bartoszp1992/boardConsole2/doc/datasheets/555 ignition circuit.png

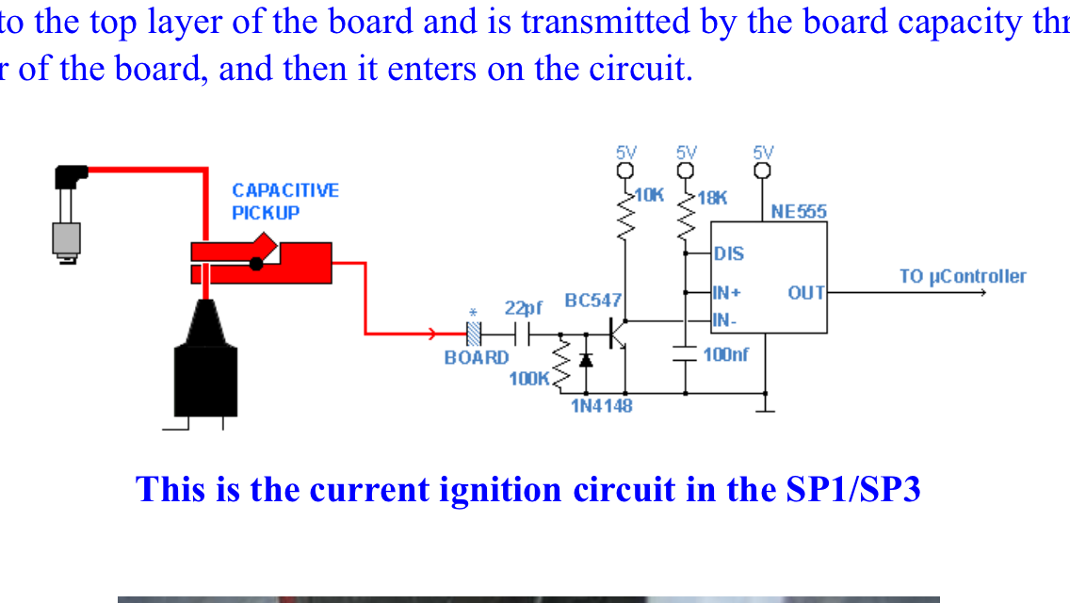
doc/datasheets/555 ignition circuit.png
