bartoszp1992/boardConsole2/boardConsolePCB/output/V2/boardConsolePCB_BOM.ods

Id | Designator | Footprint | Quantity | Designation | Supplier and ref
1 | C18,C24 | CP_D8mm_H13mm_P3.5mm_horizontal | 2 | 100u
2 | D1,D4,D3 | LED_0603_1608Metric | 3 | LED
3 | R27,R13,R12,R28,R26 | R_0603_1608Metric | 5 | 4k7
4 | L1 | C_0603_1608Metric | 1 | 47n
5 | R33,R39,R37,R14,R32,R23,R25,R20,R4,R6 | R_0603_1608Metric | 10 | 1k
6 | C9,C40,C32,C11,C5,C16,C39,C4,C29,C14,C17,C22,C37,C1,C6,C38,C23 | C_0603_1608Metric | 17 | 100n
7 | R40,R24,R2,R36,R41,R5,R38,R19 | R_0603_1608Metric | 8 | 10k
8 | D6 | LED_0603_1608Metric | 1 | STAT2
9 | R15,R7,R18 | R_1206_3216Metric | 3 | 220R
10 | BT1 | BatteryHolder_Keystone_1060_1x2032 | 1 | CH004-2032
11 | C10,C28 | CP_D8mm_H13mm_P3.5mm_horizontal | 2 | 0m1
12 | U6 | TO-252-2 | 1 | AZ1117-5.0
13 | F3,F2 | Fuse_0603_1608Metric | 2 | 100mA
14 | R16,R17 | R_2512_6332Metric | 2 | 0R
15 | C25 | C_0603_1608Metric | 1 | 100p/0R
16 | U9 | DIP-8_W7.62mm | 1 | AT24C04C
17 | F1 | Fuse_1206_3216Metric | 1 | 1A
18 | C36,C21,C34,C20,C35,C19,C33,C15 | C_0603_1608Metric | 8 | 1u
19 | U8 | TSSOP-20_4.4x6.5mm_P0.65mm | 1 | TXS0108EPW
20 | R29,R30,R31 | R_0805_2012Metric | 3 | 100R
21 | R3,R34 | R_2512_6332Metric | 2 | 4k3
22 | U1 | DIP-8_W7.62mm | 1 | NE555P
23 | R22 | R_0603_1608Metric | 1 | 6k8
24 | D13,D5 | D_MiniMELF | 2 | LL4148-DIO
25 | U2 | TO-252-2 | 1 | AZ1117-3.3
26 | D8 | LED_0603_1608Metric | 1 | STAT1
27 | J6 | PinHeader_1x04_P2.54mm_Vertical | 1 | FUEL/TRIM
28 | J2 | SMA-F | 1 | SMA F
29 | D10,D11 | D_SOD-923 | 2 | ESD9R3.3ST5G
30 | U7 | WH1602L1-YYH-CT010 | 1 | ABC016002C34-FHA-R-01
31 | LS1 | Buzzer_12x9.5RM7.6 | 1 | HCM1205/A2
32 | C31 | CP_D12.5mm_H22mm_P5.0mm_horizontal | 1 | 1000uF
33 | U3 | LQFP-64_10x10mm_P0.5mm | 1 | STM32G071RBTx
34 | R35,R9 | R_0603_1608Metric | 2 | 0R
35 | Q1 | TO-92_Inline | 1 | BC548
36 | Q2,Q3 | SOT-23 | 2 | IRML0030TR
37 | D9 | D_MiniMELF | 1 | BZV55C3V9
38 | D2 | D_SMB | 1 | SMBJ5.0A
39 | R10 | R_0603_1608Metric | 1 | 10R
40 | D7 | D_SMA | 1 | ES1D
41 | U5 | L76-L | 1 | L76-L
42 | C12,C13 | C_0603_1608Metric | 2 | 10p
43 | R21 | R_0603_1608Metric | 1 | 2k2
44 | RV1 | Potentiometer_ACP_CA9-H5_Horizontal | 1 | 10k
45 | Y2 | Crystal_SMD_HC49-SD | 1 | 16M
46 | R1 | R_0805_2012Metric | 1 | 220R
47
 | EXTERNAL
1 | power/ignition: 1x SP1112/S3-C + SP1110/P3II-N
2 | trim/fuel: 1xSP1112/S5-C + SP1110/P5II-N
3 | display: SP2112/S12-1C + SP2110/P12II-1N
4 | switches: 3x PBS10BB
5 | case: kradex ZP150.100.45UJPH semi
6 | GPS antenna: SMA type, 50R
7 | distance: 4xDMM3WW12 + 8xWWKM3004C
8 | antenna cable: 1xSMA-SMF/50/01(10cm RG174 SMA-F/SMA-M)
9 | gland: DP-EN 12 HM
10 | goldpins: 1x40 2x f/1x40 2x m
