bartoszp1992/boardConsole2/boardConsolePCB/additionals/LIB_WH1602L/WH1602L/3D/WH1602L.stp

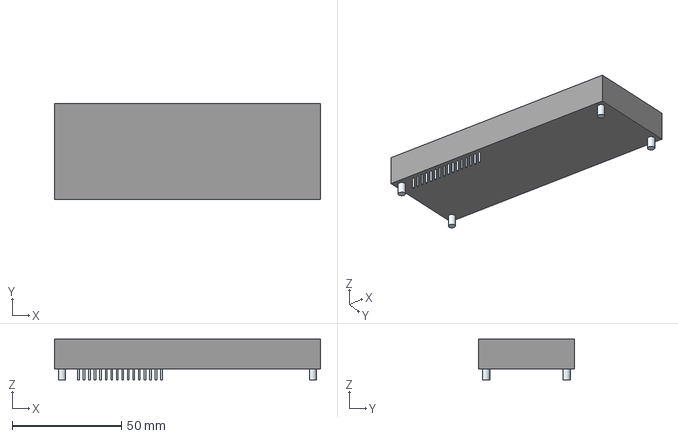
[picture p2: CAD file, 2023-12-22]
boardConsolePCB/additionals/LIB_WH1602L/WH1602L/3D/WH1602L.stp
122.0 x 44.0 x 18.7 mm
Leads
