bartoszp1992/boardConsole2/boardConsolePCB/additionals/PinSocket_1x16_P2.54mm_Vertical.step

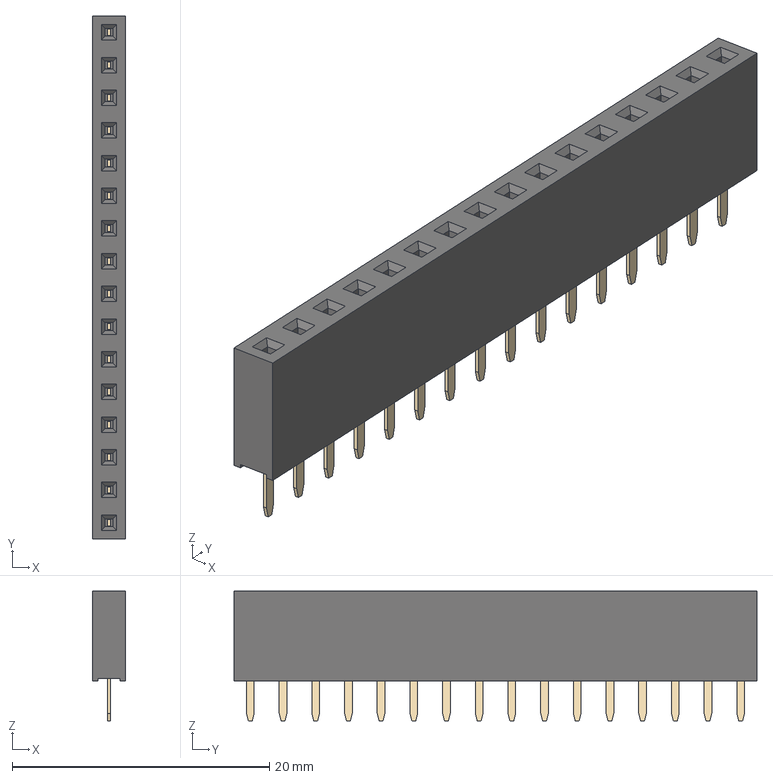
[picture p3: CAD file, 2023-12-22]
boardConsolePCB/additionals/PinSocket_1x16_P2.54mm_Vertical.step
2.54 x 40.6 x 10.1 mm
