bartoszp1992/boardConsole2/mechanical/shade.FCStd

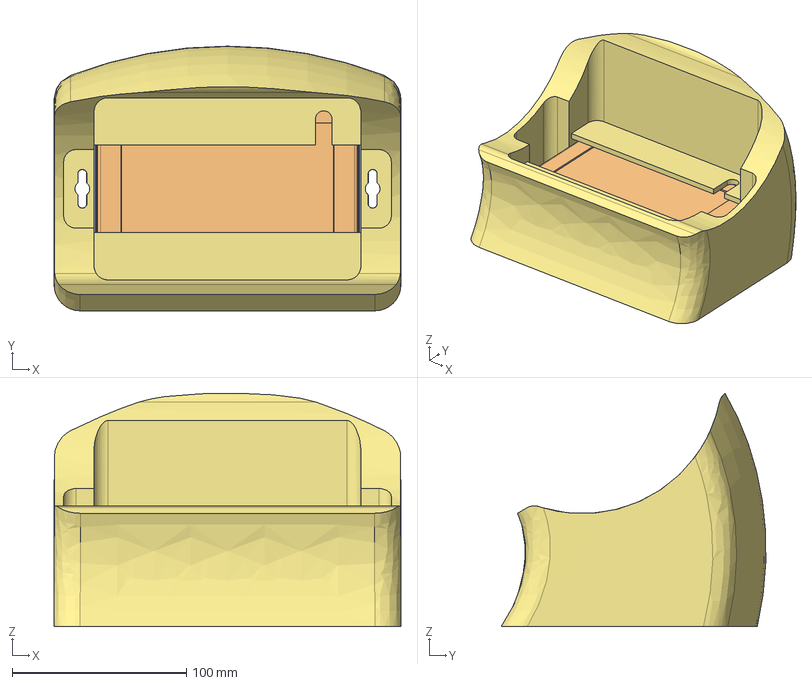
[picture p4: CAD file, 2024-12-17]
mechanical/shade.FCStd
199.1 x 151.9 x 133.8 mm
podstawa
Pokrywa
Sleeve
Sleeve001
Sleeve002
Sleeve003
LED_0603_1608Metric
R_0603_1608Metric
C_0603_1608Metric
R_0603_1608Metric002
R_0603_1608Metric004
R_0603_1608Metric006
C_0603_1608Metric002
R_0603_1608Metric008
C_0603_1608Metric004
LED_0603_1608Metric002
LED_0603_1608Metric004
R_1206_3216Metric
Keystone_1060_1x2032
C_Disc_D80mm_W50mm_P750mm
CQ assembly
CQ assembly001
CQ assembly002
CQ assembly003
CQ assembly004
C_0603_1608Metric006
R_0603_1608Metric010
C_0603_1608Metric008
R_0603_1608Metric012
Fuse_0603_1608Metric
PinHeader_1x02_P254mm_Vertical
R_2512_6332Metric
C_0603_1608Metric010
C_0603_1608Metric012
R_0603_1608Metric014
C_0603_1608Metric014
DIP-8_W7.62mm
Fuse_1206_3216Metric
C_0603_1608Metric016
TSSOP_20_44x65mm_P065mm
R_0805_2012Metric
C_0603_1608Metric018
C_0603_1608Metric020
C_0603_1608Metric022
C_0603_1608Metric024
R_2512_6332Metric002
DIP-8_W7.62mm002
Fuse_0603_1608Metric002
R_0603_1608Metric016
PinHeader_1x05_P254mm_Vertical
C_0603_1608Metric026
R_0805_2012Metric002
D_MiniMELF_Standard
R_0603_1608Metric018
C_0603_1608Metric028
CQ assembly006
CQ assembly007
CQ assembly008
CQ assembly009
CQ assembly010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
