bartoszp1992/boardConsole2/mechanical/shade-Body.stl

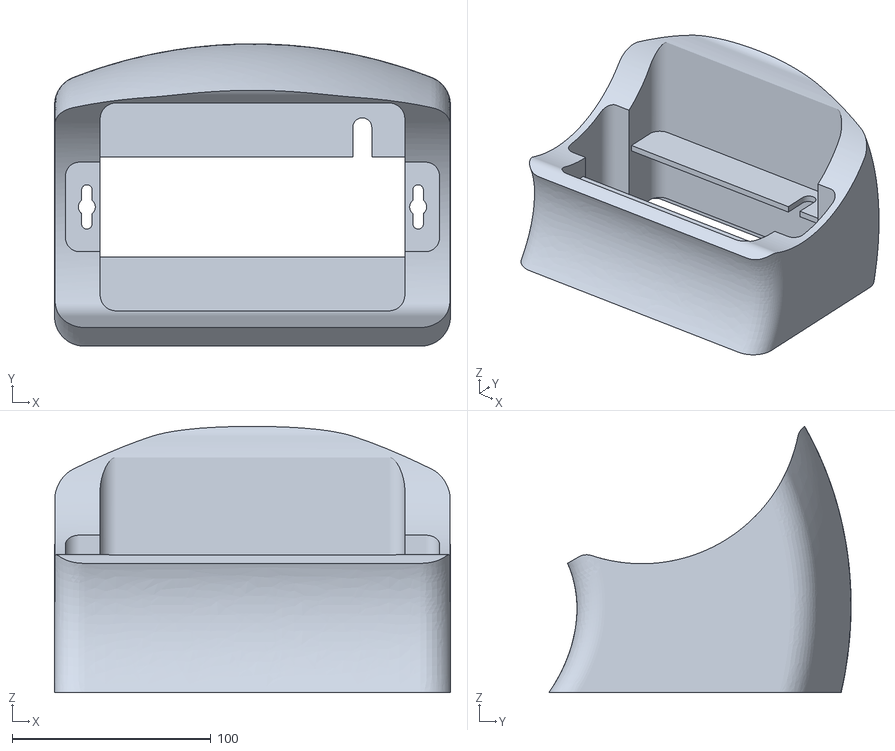
[picture p5: CAD file, 2024-12-17]
mechanical/shade-Body.stl
199.1 x 152.0 x 133.8
