bartoszp1992/boardConsole2/(list of files, cad)

Other CAD files:
boardConsolePCB/additionals/LIB_WH1602L/WH1602L/Allegro/wh1602l.psm
boardConsolePCB/additionals/LIB_WH1602L/WH1602L/DEHDL/wh1602l/chips/chips.prt
