bartoszp1992/boardConsole2/boardConsolePCB/output/V2/boardConsolePCB.pdf

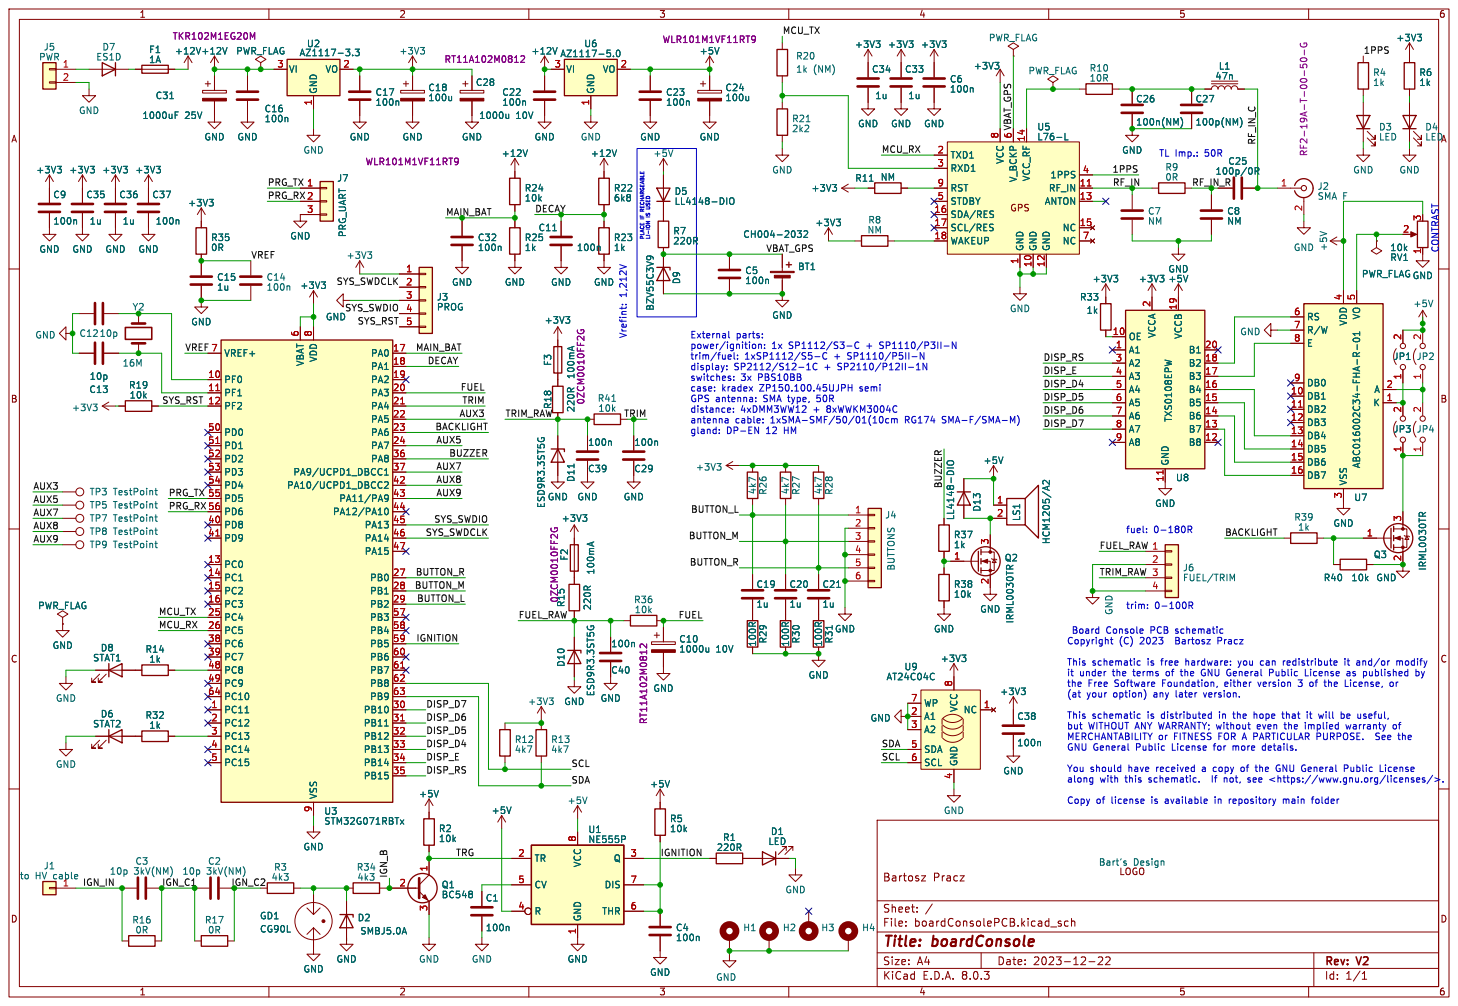
[picture p6: page 1]

1 GND 10 RF_IN 11 GND 12 ANTON 13 VCC_RF 14 NC 15 SDA/RES 16 SCL/RES 17 WAKEUP 18 TXD1 2 RXD1 3

gland: DP-EN 12 HM

4 SDA 5 SCL 6 WP 7 VCC
