bartoszp1992/boardConsole2/boardConsolePCB/output/V2/handSolder.pdf

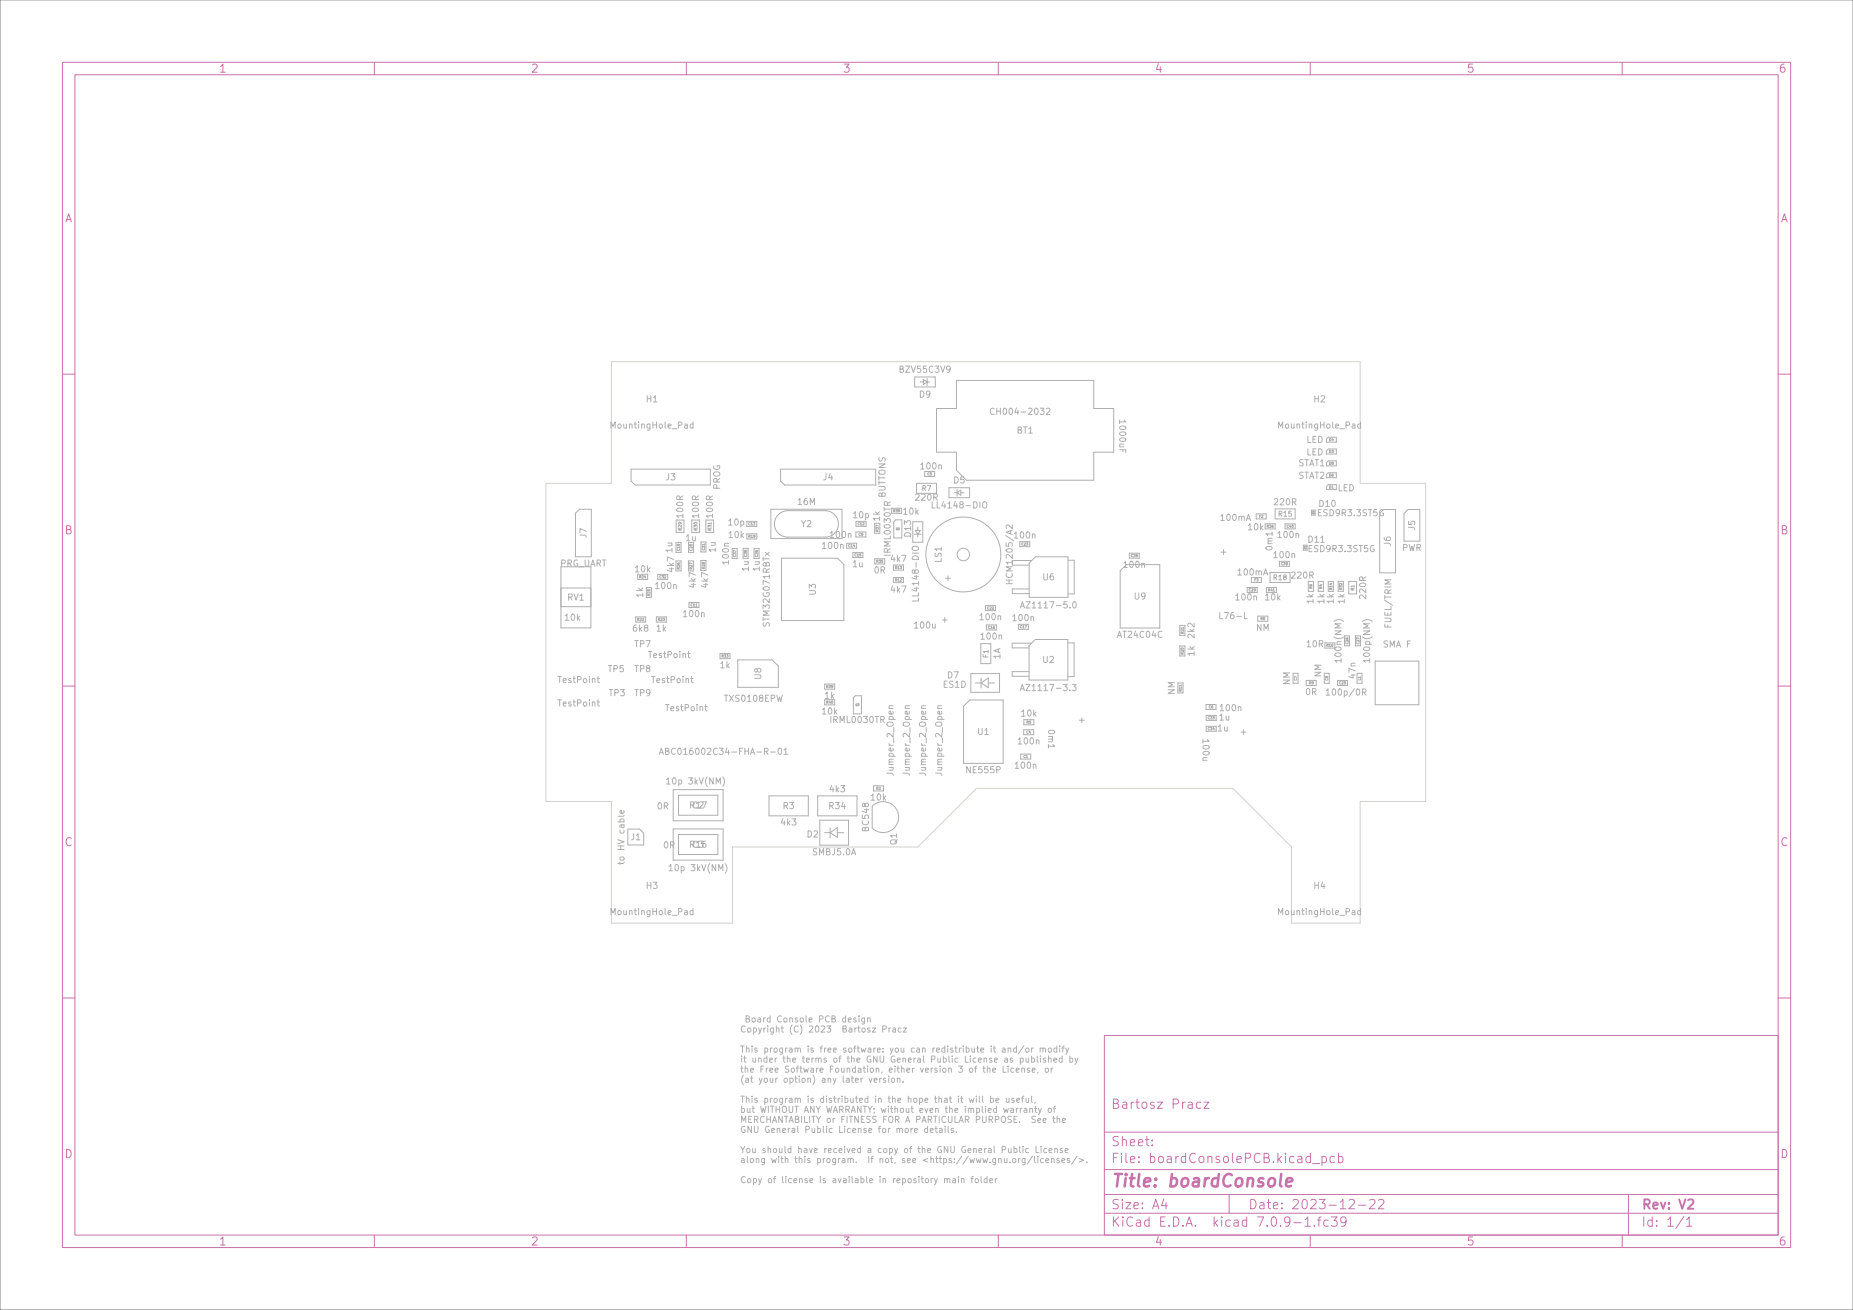
[picture p8: page 1]
