bartoszp1992/boardConsole2/(list of files, drawings)

Other design files:
boardConsolePCB/additionals/LIB_WH1602L/WH1602L/Altium/WH1602L.PcbLib
boardConsolePCB/additionals/LIB_WH1602L/WH1602L/Altium/WH1602L.SchLib
