bartoszp1992/boardConsole2/boardConsolePCB/boardConsolePCB.kicad_pcb

## KiCad design boardConsolePCB/boardConsolePCB.kicad_pcb (2024-12-17)

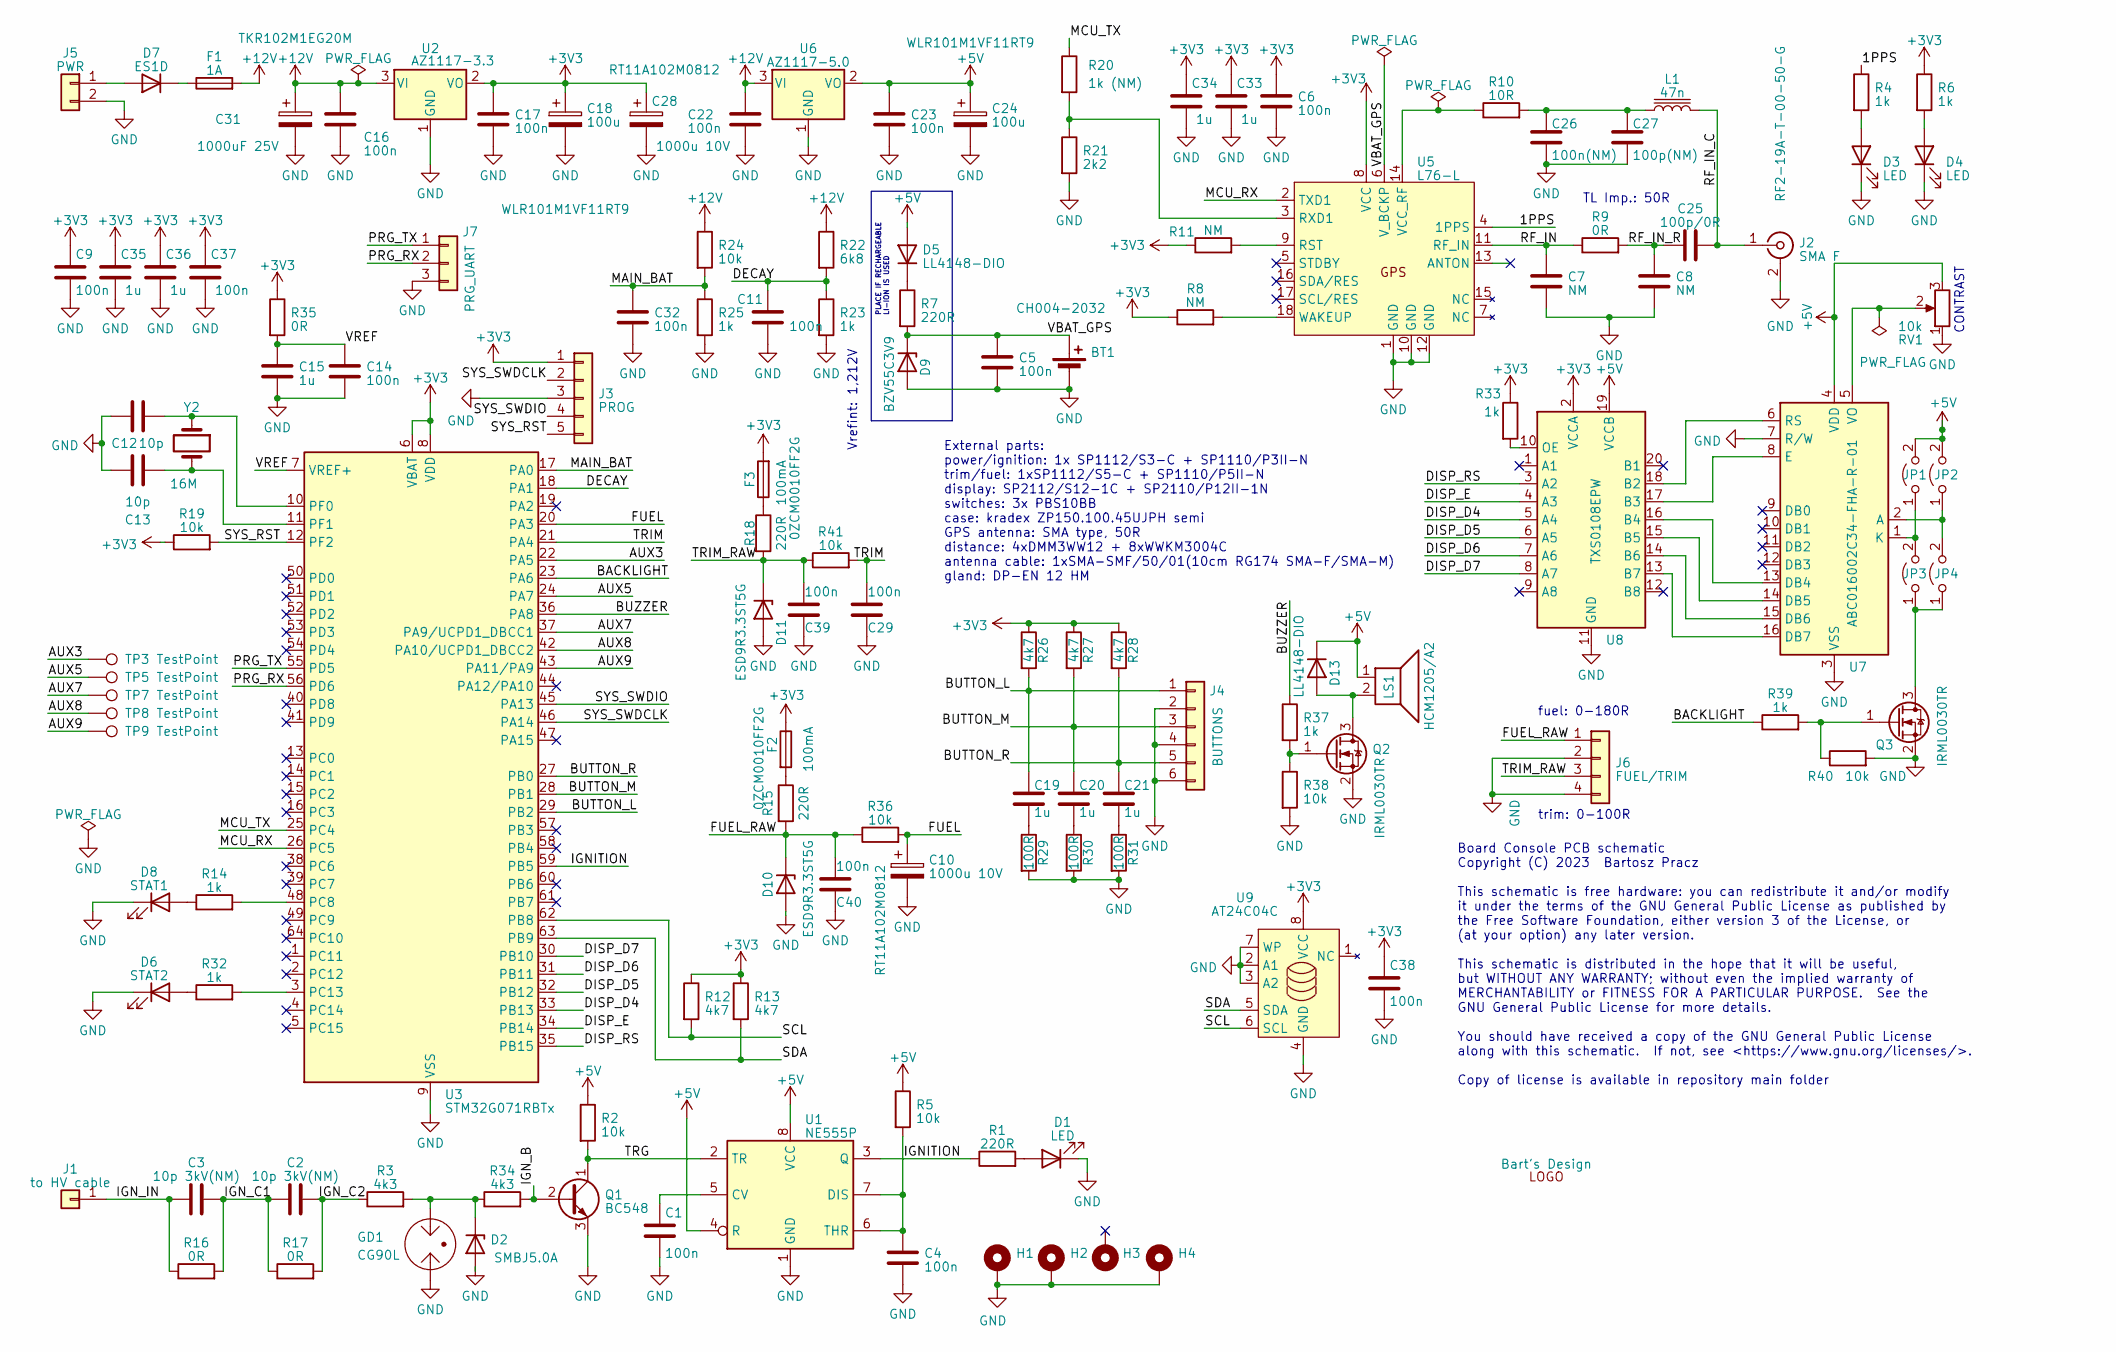
[picture p9: schematic boardConsolePCB.kicad_sch, boardConsole]

Parts:
BT1: CH004-2032; BatteryHolder_Keystone_1060_1x2032
C1, C4, C5, C6, C9, C11, C14, C16, C17, C22, C23, C29, C32, C37, C38, C39, C40: 100n; C_0603_1608Metric
C2, C3: 10p 3kV(NM); C_Disc_D8.0mm_W5.0mm_P7.50mm
C7, C8: NM; C_0603_1608Metric
C10, C28: 1000u 10V; CP_D8mm_H13mm_P3.5mm_horizontal
C12, C13: 10p; C_0603_1608Metric
C15, C19, C20, C21, C33, C34, C35, C36: 1u; C_0603_1608Metric
C18, C24: 100u; CP_D8mm_H13mm_P3.5mm_horizontal
C25: 100p/0R; C_0603_1608Metric
C26: 100n(NM); C_0603_1608Metric
C27: 100p(NM); C_0603_1608Metric
C31: 1000uF 25V; CP_D12.5mm_H22mm_P5.0mm_horizontal
D1, D3, D4: LED; LED_0603_1608Metric
D2: SMBJ5.0A; D_SMB
D5, D13: LL4148-DIO; D_MiniMELF
D6: STAT2; LED_0603_1608Metric
D7: ES1D; D_SMA
D8: STAT1; LED_0603_1608Metric
D9: BZV55C3V9; D_MiniMELF
D10, D11: ESD9R3.3ST5G; D_SOD-923
F1: 1A; Fuse_1206_3216Metric
F2, F3: 100mA; Fuse_0603_1608Metric
GD1: CG90L
H1, H2, H3, H4: MountingHole_Pad; MountingHole_3.2mm_M3_Pad
J1: to HV cable; PinHeader_1x01_P2.54mm_Vertical
J2: SMA F; SMA-F
J3: PROG; PinHeader_1x05_P2.54mm_Vertical
J4: BUTTONS; PinHeader_1x06_P2.54mm_Vertical
J5: PWR; PinHeader_1x02_P2.54mm_Vertical
J6: FUEL/TRIM; PinHeader_1x04_P2.54mm_Vertical
J7: PRG_UART; PinHeader_1x03_P2.54mm_Vertical
JP1, JP2, JP3, JP4: Jumper_2_Open; SolderJumper-2_P1.3mm_Open_TrianglePad1.0x1.5mm
L1: 47n; C_0603_1608Metric
LS1: HCM1205/A2; Buzzer_12x9.5RM7.6
Q1: BC548; TO-92_Inline
Q2, Q3: IRML0030TR; SOT-23
R1: 220R; R_0805_2012Metric
R2, R5, R19, R24, R36, R38, R40, R41: 10k; R_0603_1608Metric
R3, R34: 4k3; R_2512_6332Metric
R4, R6, R14, R23, R25, R32, R33, R37, R39: 1k; R_0603_1608Metric
R7, R15, R18: 220R; R_1206_3216Metric
R8, R11: NM; R_0603_1608Metric
R9, R35: 0R; R_0603_1608Metric
R10: 10R; R_0603_1608Metric
R12, R13, R26, R27, R28: 4k7; R_0603_1608Metric
R16, R17: 0R; R_2512_6332Metric
R20: 1k (NM); R_0603_1608Metric
R21: 2k2; R_0603_1608Metric
R22: 6k8; R_0603_1608Metric
R29, R30, R31: 100R; R_0805_2012Metric
RV1: 10k; Potentiometer_ACP_CA9-H5_Horizontal
TP3, TP5, TP7, TP8, TP9: TestPoint; TestPoint_Pad_2.0x2.0mm
U1: NE555P; DIP-8_W7.62mm
U2: AZ1117-3.3; TO-252-2
U3: STM32G071RBTx; LQFP-64_10x10mm_P0.5mm
U5: L76-L
U6: AZ1117-5.0; TO-252-2
U7: ABC016002C34-FHA-R-01; WH1602L1-YYH-CT010
U8: TXS0108EPW; TSSOP-20_4.4x6.5mm_P0.65mm
U9: AT24C04C; DIP-8_W7.62mm
X1: Bart's Design; BD_full 20x5.2
Y2: 16M; Crystal_SMD_HC49-SD

Connections:
+3V3: C6.1, C9.1, C17.1, C18.1, C28.1, C33.1, C34.1, C35.1, C36.1, C37.1, C38.1, F2.1, F3.2, J3.1, R6.1, R8.1, R11.1, R12.1, R13.1, R19.1, R26.1, R27.1, R28.1, R33.1, R35.1, U2.2 (VO), U3.6 (VBAT), U3.8 (VDD), U5.8 (VCC), U8.2 (VCCA), U9.8 (VCC)
+5V: C23.1, C24.1, D5.2 (A), D13.1 (K), JP1.2 (B), JP2.2 (B), LS1.1, R2.1, R5.1, RV1.3, U1.4 (R), U1.8 (VCC), U6.2 (VO), U7.4 (VDD), U8.19 (VCCB)
+12V: C16.1, C22.1, C31.1, F1.2, R22.1, R24.1, U2.3 (VI), U6.3 (VI)
/1PPS: R4.1, U5.4 (1PPS)
/AUX3: TP3.1, U3.22 (PA5)
/AUX5: TP5.1, U3.24 (PA7)
/AUX7: TP7.1, U3.37 (PA9/UCPD1_DBCC1)
/AUX8: TP8.1, U3.42 (PA10/UCPD1_DBCC2)
/AUX9: TP9.1, U3.43 (PA11/PA9)
/BACKLIGHT: R39.1, U3.23 (PA6)
/BUTTON_L: C19.1, J4.1, R26.2, U3.29 (PB2)
/BUTTON_M: C20.1, J4.3, R27.2, U3.28 (PB1)
/BUTTON_R: C21.1, J4.5, R28.2, U3.27 (PB0)
/BUZZER: R37.1, U3.36 (PA8)
/DECAY: C11.1, R22.2, R23.1, U3.18 (PA1)
/DISP_D4: U3.33 (PB13), U8.5 (A4)
/DISP_D5: U3.32 (PB12), U8.6 (A5)
/DISP_D6: U3.31 (PB11), U8.7 (A6)
/DISP_D7: U3.30 (PB10), U8.8 (A7)
/DISP_E: U3.34 (PB14), U8.4 (A3)
/DISP_RS: U3.35 (PB15), U8.3 (A2)
/FUEL: C10.1, R36.2, U3.20 (PA3)
/FUEL_RAW: C40.1, D10.1 (K), J6.1, R15.2, R36.1
/IGNITION: R1.1, U1.3 (Q), U3.59 (PB5)
/IGN_B: Q1.2 (B), R34.2
/IGN_C1: C2.1, C3.2, R16.2, R17.1
/IGN_C2: C2.2, R3.1, R17.2
/IGN_IN: C3.1, J1.1, R16.1
/MAIN_BAT: C32.1, R24.2, R25.1, U3.17 (PA0)
/MCU_RX: U3.26 (PC5), U5.2 (TXD1)
/MCU_TX: R20.1, U3.25 (PC4)
/PRG_RX: J7.2, U3.56 (PD6)
/PRG_TX: J7.1, U3.55 (PD5)
/RF_IN: C7.1, R9.1, U5.11 (RF_IN)
/RF_IN_C: C25.2, J2.1 (In), L1.2
/RF_IN_R: C8.1, C25.1, R9.2
/SCL: R12.2, U3.62 (PB8), U9.6 (SCL)
/SDA: R13.2, U3.63 (PB9), U9.5 (SDA)
/SYS_RST: J3.5, R19.2, U3.12 (PF2)
/SYS_SWDCLK: J3.2, U3.46 (PA14)
/SYS_SWDIO: J3.4, U3.45 (PA13)
/TRG: Q1.1 (C), R2.2, U1.2 (TR)
/TRIM: C29.1, R41.2, U3.21 (PA4)
/TRIM_RAW: C39.1, D11.1 (K), J6.3, R18.2, R41.1
/VBAT_GPS: BT1.1 (+), C5.1, D9.1 (K), R7.2, U5.6 (V_BCKP)
/VREF: C14.1, C15.1, R35.2, U3.7 (VREF+)
GND: BT1.2 (-), C1.2, C4.2, C5.2, C6.2, C7.2, C8.2, C9.2, C10.2, C11.2, C12.1, C13.1, C14.2, C15.2, C16.2, C17.2, C18.2, C22.2, C23.2, C24.2, C26.2, C27.2, C28.2, C29.2, C31.2, C32.2, C33.2, C34.2, C35.2, C36.2, C37.2, C38.2, C39.2, C40.2, D1.1 (K), D2.2 (A), D3.1 (K), D4.1 (K), D6.1 (K), D8.1 (K), D9.2 (A), D10.2 (A), D11.2 (A), GD1.1, H1.1, H2.1, H4.1, J2.2 (Ext), J3.3, J4.2, J4.4, J4.6, J5.2, J6.2, J6.4, J7.3, Q1.3 (E), Q2.2 (S), Q3.2 (S), R21.2, R23.2, R25.2, R29.2, R30.2, R31.2, R38.2, R40.2, RV1.1, U1.1 (GND), U2.1 (GND), U3.9 (VSS), U5.1 (GND), U5.10 (GND), U5.12 (GND), U6.1 (GND), U7.3 (VSS), U7.7 (R/W), U8.11 (GND), U9.2 (A1), U9.3 (A2), U9.4 (GND), U9.7 (WP)
unnamed: C19.2, R29.1
unnamed: C20.2, R30.1
unnamed: C21.2, R31.1
unnamed: C26.1, C27.1, L1.1, R10.2
unnamed: D1.2 (A), R1.2
unnamed: D2.1 (K), GD1.3, R3.2, R34.1
unnamed: D3.2 (A), R4.2
unnamed: D4.2 (A), R6.2
unnamed: D5.1 (K), R7.1
unnamed: D6.2 (A), R32.1
unnamed: D7.2 (A), J5.1
unnamed: D7.1 (K), F1.1
unnamed: D8.2 (A), R14.1
unnamed: D13.2 (A), LS1.2, Q2.3 (D)
unnamed: F2.2, R15.1
unnamed: F3.1, R18.1
unnamed: JP1.1 (A), JP3.2 (B), U7.1 (K)
unnamed: JP2.1 (A), JP4.2 (B), U7.2 (A)
unnamed: JP3.1 (A), JP4.1 (A), Q3.3 (D)
unnamed: Q2.1 (G), R37.2, R38.1
unnamed: Q3.1 (G), R39.2, R40.1
unnamed: C1.1, U1.5 (CV)
unnamed: C4.1, R5.2, U1.6 (THR), U1.7 (DIS)
unnamed: R14.2, U3.48 (PC8)
unnamed: R32.2, U3.3 (PC13)
unnamed: C12.2, U3.10 (PF0), Y2.1
unnamed: C13.2, U3.11 (PF1), Y2.2
unnamed: R11.2, U5.9 (RST)
unnamed: R20.2, R21.1, U5.3 (RXD1)
unnamed: R10.1, U5.14 (VCC_RF)
unnamed: R8.2, U5.18 (WAKEUP)
unnamed: U7.13 (DB4), U8.16 (B4)
unnamed: U7.14 (DB5), U8.15 (B5)
unnamed: U7.15 (DB6), U8.14 (B6)
unnamed: U7.16 (DB7), U8.13 (B7)
unnamed: U7.8 (E), U8.17 (B3)
unnamed: U7.6 (RS), U8.18 (B2)
unnamed: RV1.2, U7.5 (VO)
unnamed: R33.2, U8.10 (OE)

Notes on the sheet:
External parts: power/ignition: 1x SP1112/S3-C + SP1110/P3II-N trim/fuel: 1xSP1112/S5-C + SP1110/P5II-N display: SP2112/S12-1C + SP2110/P12II-1N switches: 3x PBS10BB case: kradex ZP150.100.45UJPH semi GPS antenna: SMA type, 50R distance: 4xDMM3WW12 + 8xWWKM3004C antenna cable: 1xSMA-SMF/50/01(10cm 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
Board Console PCB schematic Copyright (C) 2023 Bartosz Pracz This schematic is free hardware: you can redistribute it and/or modify it under the terms of the GNU General Public License as published by the Free Software Foundation, either version 3 of the License, or (at your option) any later versi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
trim: 0-100R
PLACE IF RECHARGEABLE LI-ION IS USED
CONTRAST
Vrefint: 1,212V
fuel: 0-180R
TL Imp.: 50R

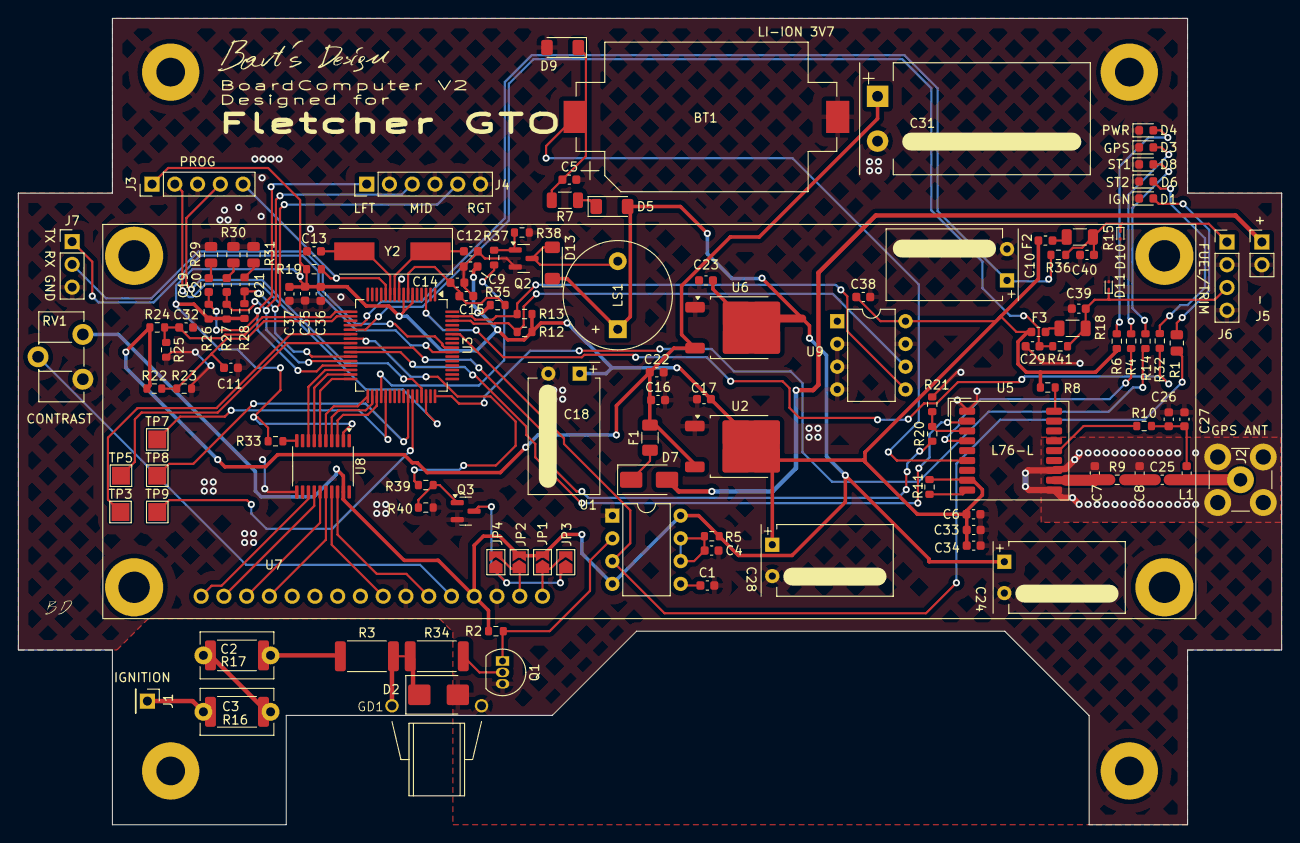
[picture p10: board boardConsolePCB.kicad_pcb from above]

Board: 2 copper layers, 141.0 x 90.0 mm, 133 parts (0 on the bottom side), 86 nets.
