bartoszp1992/boardConsole2/boardConsoleFirmware2/Src/main.c

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
/* Includes ------------------------------------------------------------------*/
#include "main.h"
#include "adc.h"
#include "comp.h"
#include "dma.h"
#include "i2c.h"
#include "tim.h"
#include "usart.h"
#include "gpio.h"

/* USER CODE BEGIN Includes */
#include "boardConsole/interrupts.h"
/* USER CODE END Includes */


void SystemClock_Config(void);
/**
  * @brief  The application entry point.
  * @retval int
  */
int main(void)
{
  /* MCU Configuration--------------------------------------------------------*/

  /* Reset of all peripherals, Initializes the Flash interface and the Systick. */
  HAL_Init();

  /* Configure the system clock */
  SystemClock_Config();

  /* Initialize all configured peripherals */
  MX_GPIO_Init();
  MX_DMA_Init();
  MX_USART1_UART_Init();
  MX_ADC1_Init();
  MX_COMP1_Init();
  MX_I2C1_Init();
  MX_TIM2_Init();
  MX_USART2_UART_Init();
  MX_TIM17_Init();
  MX_TIM3_Init();
  MX_TIM16_Init();
  MX_TIM6_Init();
  /* USER CODE BEGIN 2 */

	boardComputer_process();

  /* USER CODE END 2 */

  /* Infinite loop */
  /* USER CODE BEGIN WHILE */
	while (1) {

    /* USER CODE END WHILE */

    /* USER CODE BEGIN 3 */
	}
  /* USER CODE END 3 */
}

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
/* USER CODE BEGIN 4 */
/*-----------------------------------------------------------*/

/* configUSE_STATIC_ALLOCATION is set to 1, so the application must provide an
 * implementation of vApplicationGetIdleTaskMemory() to provide the memory that is
 * used by the Idle task. */
void vApplicationGetIdleTaskMemory(StaticTask_t **ppxIdleTaskTCBBuffer,
		StackType_t **ppxIdleTaskStackBuffer, uint32_t *pulIdleTaskStackSize) {
	/* If the buffers to be provided to the Idle task are declared inside this
	 * function then they must be declared static - otherwise they will be allocated on
	 * the stack and so not exists after this function exits. */
	static StaticTask_t xIdleTaskTCB;
	static StackType_t uxIdleTaskStack[configMINIMAL_STACK_SIZE];

	/* Pass out a pointer to the StaticTask_t structure in which the Idle task's
	 * state will be stored. */
	*ppxIdleTaskTCBBuffer = &xIdleTaskTCB;

	/* Pass out the array that will be used as the Idle task's stack. */
	*ppxIdleTaskStackBuffer = uxIdleTaskStack;

	/* Pass out the size of the array pointed to by *ppxIdleTaskStackBuffer.
	 * Note that, as the array is necessarily of type StackType_t,
	 * configMINIMAL_STACK_SIZE is specified in words, not bytes. */
	*pulIdleTaskStackSize = configMINIMAL_STACK_SIZE;
}
/*-----------------------------------------------------------*/

/* configUSE_STATIC_ALLOCATION and configUSE_TIMERS are both set to 1, so the
 * application must provide an implementation of vApplicationGetTimerTaskMemory()
 * to provide the memory that is used by the Timer service task. */
void vApplicationGetTimerTaskMemory(StaticTask_t **ppxTimerTaskTCBBuffer,
		StackType_t **ppxTimerTaskStackBuffer, uint32_t *pulTimerTaskStackSize) {
	/* If the buffers to be provided to the Timer task are declared inside this
	 * function then they must be declared static - otherwise they will be
	 * allocated on the stack and so not exists after this function exits. */
	static StaticTask_t xTimerTaskTCB;
	static StackType_t uxTimerTaskStack[configTIMER_TASK_STACK_DEPTH];

	/* Pass out a pointer to the StaticTask_t structure in which the Timer
	 * task's state will be stored. */
	*ppxTimerTaskTCBBuffer = &xTimerTaskTCB;

	/* Pass out the array that will be used as the Timer task's stack. */
	*ppxTimerTaskStackBuffer = uxTimerTaskStack;

	/* Pass out the size of the array pointed to by *ppxTimerTaskStackBuffer.
	 * Note that, as the array is necessarily of type StackType_t,
	 * configMINIMAL_STACK_SIZE is specified in words, not bytes. */
	*pulTimerTaskStackSize = configTIMER_TASK_STACK_DEPTH;
}
/*-----------------------------------------------------------*/
/* USER CODE END 4 */

/**
  * @brief  Period elapsed callback in non blocking mode
  * @note   This function is called  when TIM7 interrupt took place, inside
  * HAL_TIM_IRQHandler(). It makes a direct call to HAL_IncTick() to increment
  * a global variable "uwTick" used as application time base.
  * @param  htim : TIM handle
  * @retval None
  */
void HAL_TIM_PeriodElapsedCallback(TIM_HandleTypeDef *htim)
{
  if (htim->Instance == TIM7) {
    HAL_IncTick();
  }
  /* USER CODE BEGIN Callback 1 */
	periodElapsedCallback(htim);
  /* USER CODE END Callback 1 */
}

/**
  * @brief  This function is executed in case of error occurrence.
  * @retval None
  */
void Error_Handler(void)
{
  /* USER CODE BEGIN Error_Handler_Debug */
	/* User can add his own implementation to report the HAL error return state */
	__disable_irq();
	while (1) {
	}
  /* USER CODE END Error_Handler_Debug */
}

#ifdef  USE_FULL_ASSERT
/**
  * @brief  Reports the name of the source file and the source line number
  *         where the assert_param error has occurred.
  * @param  file: pointer to the source file name
  * @param  line: assert_param error line source number
  * @retval None
  */
void assert_failed(uint8_t *file, uint32_t line)
{
  /* USER CODE BEGIN 6 */
  /* User can add his own implementation to report the file name and line number,
     ex: printf("Wrong parameters value: file %s on line %d\r\n", file, line) */
  /* USER CODE END 6 */
}
#endif /* USE_FULL_ASSERT */
