bartoszp1992/boardConsole2/boardConsoleFirmware2/boardConsoleFirmware2.ioc

Mcu.UserName=STM32G071RBTx
PA0.GPIO_Label=ADC_BAT
PA0.Signal=ADC1_IN0
PA1.GPIO_Label=DECAY
PA1.Signal=COMP1_INP
PA13.Signal=SYS_SWDIO
PA14-BOOT0.Signal=SYS_SWCLK
PA3.GPIO_Label=ADC_FUEL
PA3.Signal=ADC1_IN3
PA4.GPIO_Label=ADC_TRIM
PA4.Signal=ADC1_IN4
PA5.GPIO_Label=TEST
PA5.Signal=GPIO_Output
PA6.GPIO_Label=BACKLIGHT
PA6.Signal=S_TIM3_CH1
PA8.GPIO_Label=BUZZER
PA8.Signal=GPIO_Output
PB0.GPIO_Label=BUTTON_R
PB0.Signal=GPIO_Input
PB1.GPIO_Label=BUTTON_M
PB1.Signal=GPIO_Input
PB10.GPIO_Label=LCD_DB7
PB10.Signal=GPIO_Output
PB11.GPIO_Label=LCD_DB6
PB11.Signal=GPIO_Output
PB12.GPIO_Label=LCD_DB5
PB12.Signal=GPIO_Output
PB13.GPIO_Label=LCD_DB4
PB13.Signal=GPIO_Output
PB14.GPIO_Label=LCD_E
PB14.Signal=GPIO_Output
PB15.GPIO_Label=LCD_RS
PB15.Signal=GPIO_Output
PB2.GPIO_Label=BUTTON_L
PB2.Signal=GPIO_Input
PB5.GPIO_Label=IGNITION
PB5.Signal=GPXTI5
PB8.Signal=I2C1_SCL
PB9.Signal=I2C1_SDA
PC13.GPIO_Label=LED_STAT2
PC13.Signal=GPIO_Output
PC4.Signal=USART1_TX
PC5.Signal=USART1_RX
PC8.GPIO_Label=LED_STAT1
PC8.Signal=GPIO_Output
PD5.Signal=USART2_TX
PD6.Signal=USART2_RX
