bartoszp1992/boardConsole2/(commit log)

2024-01-24 added manu map
    [boardConsolePCB.kicad_pcb, boardConsolePCB.kicad_sch, boardConsolePCB_BOM.ods, menu map.ods]
2024-02-26 correct values for polarized caps
    [boardConsolePCB.kicad_sch]
2024-02-26 correct description for antenna TL
    [boardConsolePCB.kicad_sch]
2024-02-27 update pdf schematic
    [boardConsolePCB.kicad_sch]
2024-04-27 add working low fuel alert, add display re-init
    [fletcher_GTO.kicad_sch]
2024-04-27 low fuel alert fix
    [boardconsoleapp.c]
2024-06-08 add GDT
    [boardConsolePCB.kicad_pcb, boardConsolePCB.kicad_sch, fletcher_GTO.kicad_sch]
2024-12-17 dont know
    [fletcher_GTO.kicad_sch, trimCurrentSensor.kicad_pcb, trimCurrentSensor.kicad_sch]
2024-12-17 add shade
    [ZP150_100_45.step, boardConsolePCB.kicad_pcb, shade-Body.stl, shade.FCStd]
2024-12-17 smaller shade
    [shade-Body.stl, shade.FCStd]
